shadowlab/ATS_ETS_Mazda3_Cluster/docs/cluster_plug_16pin.png

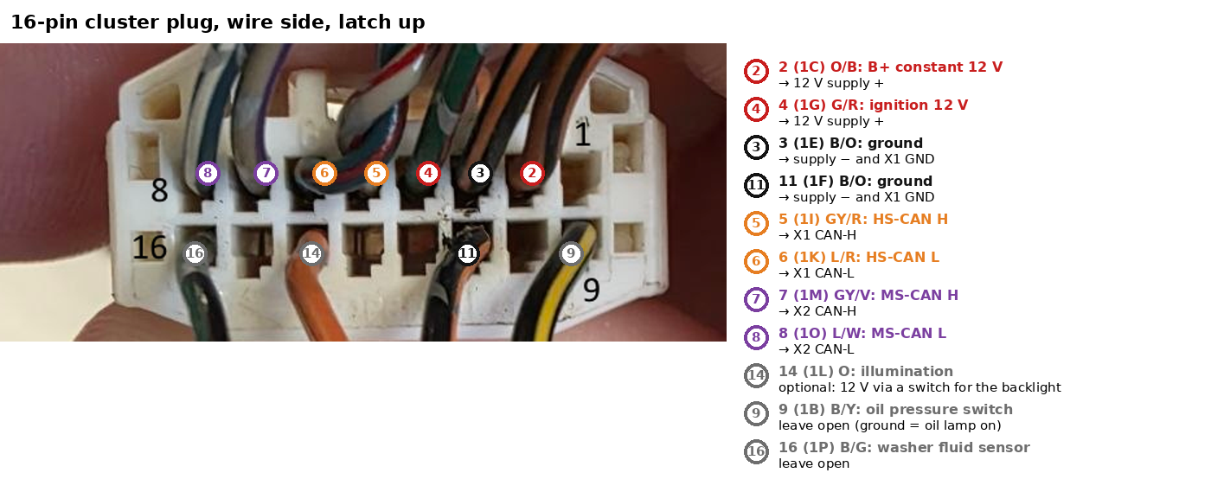
docs/cluster_plug_16pin.png
