shadowlab/ATS_ETS_Mazda3_Cluster/docs/cluster_plug_24pin.png

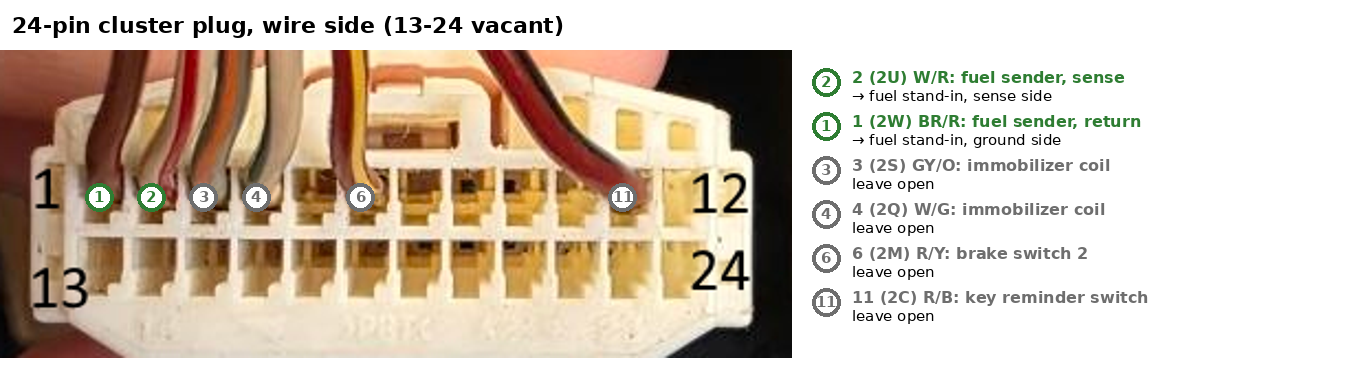
docs/cluster_plug_24pin.png
