shadowlab/ATS_ETS_Mazda3_Cluster/(commit log)

2026-10-08 Add Arduino Mega CAN bridge for Mazda 3 cluster driven by SimTools/ATS (#1)
    Firmware for an Arduino Mega 2560 + Seeed CAN-BUS shield that parses
    SimTools serial telemetry and sends the BK Mazda 3 cluster's CAN frames
    (0x201 rpm/speed, 0x4B0 wheel speeds, 0x420 coolant/lamps), plus GPIO
    outputs for hard-wired lamps, a runtime custom-frame command, a PC bench
    test script, host unit tests, and setup documentation.
    Claude-Session: https://claude.ai/code/session_01UuMMU8bTbX5keAJ1QmBZ7b
2026-10-08 Apply integration matrix mappings and add SimHub support (#3)
    - 0x201: RPM is now 1:1 and speed is km/h * 177.6, both as named
    constants in mazda3_can.h
    - 0x420: check-engine moves to byte 1 (0x40); oil pressure uses byte 4
    - Parking brake lamp now sent over CAN on 0x212 byte 4 (0x40); its GPIO
    output is disabled by default
    - Document cluster pins 1N/1P (turn signals, ground) and 1K (high beam,
    +12 V)
    - Add a SimHub custom serial device setup using the matrix properties
    - Fix custom '#' frames not overriding built-in IDs: the built-in frame
    was still sent alongside, so the cluster saw both
    Claude-Session: https://claude.ai/code/session_01UuMMU8bTbX5keAJ1QmBZ7b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
    [ATS_Mazda3_Cluster.ino, cluster_test.py, config.h, mazda3_can.h]
2026-10-08 Document the cluster pinout and calibrate speed and RPM on a real cluster (#4)
    * Document the cluster pinout from the factory wiring diagram
    The 2005 Mazda 3 cluster diagrams (0922-1a to 1d) give the connector
    pinout, so the README now lists the bench wiring pin by pin: B+ 1C, IG1 1G,
    grounds 1E/1F, HS-CAN H/L 1I/1K, plus the optional and unused pins.
    The diagrams also show the turn signal and high beam lamps are driven by
    the cluster's microcomputer, not hard-wired. The pins the README gave for
    them were wrong (1N and 1P are vacant, 1K is HS-CAN L), so the GPIO lamp
    outputs are now off by default and the README warns against driving 1K.
    The diagram draws termination inside the cluster, s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
    [ATS_Mazda3_Cluster.ino, cluster_test.py, config.h, mazda3_can.h]
2026-10-15 Drive the body-bus lamps, fuel, gear, trip meter and cruise lamps on a real 2005 cluster (#5)
    * Add an optional MS-CAN module and an ID scan to find the lamp frames
    The turn signal and high beam lamps aren't driven by anything in 0x433 on
    the main bus. They are most likely on the 125 kbit/s body bus (cluster
    positions 7/8), which the shield can't reach. This adds:
    - MS_CAN_ENABLED: a second MCP2515 module on D53, off by default
    - #m<id> ...: custom frames on that bus
    - #scan m / #scan h: all-0xFF frames on every ID, 16 at a time, 2 s per
    block, printing each block so the one that lights a lamp can be found
    Claude-Sessi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
2026-10-19 Fuel gauge reaches F, #ohms calibration command, SimHub profile (#6)
    * Support the Autosport Labs ESP32-CAN-X2 as an alternative to the Mega
    The ESP32-CAN-X2 has both CAN buses on one board, so it can replace the
    Mega and its two stacked Seeed shields. The board is picked from the
    Arduino board selection (BOARD_CAN_X2 in config.h):
    - HS-CAN (500k) runs on the ESP32's built-in TWAI controller (CAN1,
    GPIO7/6) through a small wrapper, twai_can.h, that answers the same
    calls as the Seeed mcp2515_can class, so send, receive and #stat code
    is shared. It also restarts the controller after a bus-off.
    - MS-CAN (125k) runs on the board's MCP2515 (CAN2, CS GPIO10, 16 MHz)
    with the existing Se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
2026-10-20 Support the Autosport Labs ESP32-CAN-X2 as an alternative to the Mega (#7)
    with the exist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
2026-10-20 Make the ESP32-CAN-X2 the only setup, powered from X1/X2 (#8)
    * README: power the ESP32-CAN-X2 from +12 V/GND on X1/X2
    Claude-Session: https://claude.ai/code/session_01LMWv8AnGHFvrSv73kdyrHY
    * ESP32 fuel wiring diagram: add the 2N7000 driver and 5 V pull-up
    Claude-Session: https://claude.ai/code/session_01LMWv8AnGHFvrSv73kdyrHY
    * Drop the Mega setup: the ESP32-CAN-X2 is the only supported board
    Removes the Mega + Seeed shield sections from the README, the Mega fuel
    and shield stack drawings, the Mega code paths and BODY_BUS_TEST from
    the firmware, and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
2026-10-21 README photos and trim, SimHub only, CAN activity LED (#10)
    * README: add the annotated ESP32-CAN-X2 connection photo
    * README: add labelled photos of the 16-pin and 24-pin cluster plugs
    * README: trim to the essentials, keep the web page as the only bench tester
    Removes the optional-pins table, the body bus and lamp-frame search
    sections, SimTools setup, the CAN frame reference, the serial frame
    experiments a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
